catuta0/HAB-payload/BOM.csv

References | Qty | Description | Package | Manufacturer | MPN | Mouser PN | Mouser link | Unit price | Currency | Line total | Price source | Notes
U8,U9 | 2 | TPS62160DGK step-down 3-17V 1A | VSSOP-8 (MSOP-8) | Texas Instruments | TPS62160DGKR | 595-TPS62160DGKR | https://www.mouser.com/ProductDetail/595-TPS62160DGKR | 1.56 | EUR | 3.12 | pt.mouser.com 2026-10-28, qty 1 | 3.3 V and 5 V bucks
L1,L2 | 2 | 2.2uH 20% shielded power inductor | 4x4 mm (XFL4020) | Coilcraft | XFL4020-222MEC | 994-XFL4020-222MEC | https://www.mouser.com/ProductDetail/994-XFL4020-222MEC | 1.98 | EUR | 3.96 | pt.mouser.com 2026-10-28, qty 1 | Out of stock at Mouser on 2026-10-27; alternative Wurth 74438357022 (710-74438357022, 4.1x4.1 mm) needs its land pattern checked against the XFL4020 footprint
F1 | 1 | PTC resettable fuse 1.5A hold 3A trip 16V | 1812 | Bourns | MF-MSMF150/16X-2 | 652-MF-MSMF150/16X-2 | https://www.mouser.com/ProductDetail/652-MF-MSMF150%2F16X-2 | 0.525 | EUR | 0.53 | pt.mouser.com 2026-10-28, qty 1 | Battery input protection
D2 | 1 | TVS 13V standoff bidirectional 600W | SMB (DO-214AA) | Littelfuse | SMBJ13CA | 576-SMBJ13CA | https://www.mouser.com/ProductDetail/576-SMBJ13CA | 0.525 | EUR | 0.53 | pt.mouser.com 2026-10-28, qty 1 | Battery input protection
Q11 | 1 | P-MOSFET 30V 4.3A | SOT-23 | Diodes Incorporated | DMP3056L-7 | 621-DMP3056L-7 | https://www.mouser.com/ProductDetail/621-DMP3056L-7 | 0.542 | EUR | 0.54 | pt.mouser.com 2026-10-28, qty 1 | Reverse polarity switch
R5 | 1 | 316k 1% 0805 | 0805 | Yageo | RC0805FR-07316KL | 603-RC0805FR-07316KL | https://www.mouser.com/ProductDetail/603-RC0805FR-07316KL | 0.086 | EUR | 0.09 | pt.mouser.com 2026-10-28, qty 1 | 3.3 V feedback
R7 | 1 | 523k 1% 0805 | 0805 | Yageo | RC0805FR-07523KL | 603-RC0805FR-07523KL | https://www.mouser.com/ProductDetail/603-RC0805FR-07523KL | 0.086 | EUR | 0.09 | pt.mouser.com 2026-10-28, qty 1 | 5 V feedback
R6,R8 | 2 | 100k 1% 0805 | 0805 | Yageo | RC0805FR-07100KL | 603-RC0805FR-07100KL | https://www.mouser.com/ProductDetail/603-RC0805FR-07100KL | 0.086 | EUR | 0.17 | pt.mouser.com 2026-10-28, qty 1 | Feedback bottom
R1,R2,R3,R4,R9 | 5 | 33R 1% 0805 | 0805 | Yageo | RC0805FR-0733RL | 603-RC0805FR-0733RL | https://www.mouser.com/ProductDetail/603-RC0805FR-0733RL | 0.086 | EUR | 0.43 | pt.mouser.com 2026-10-28, qty 1 | SPI series termination (R9 on SD MISO at MOD1)
C17,C19 | 2 | 10uF 50V X7R | 1210 | TDK | C3225X7R1H106K250AC | 810-C3225X7R1H106250 | https://www.mouser.com/ProductDetail/810-C3225X7R1H106250 | 0.877 | EUR | 1.75 | pt.mouser.com 2026-10-28, qty 1 | Buck input
C18,C20,C21,C23,C25 | 5 | 22uF 16V X7R | 1206 | Murata | GRM31CZ71C226ME15L | 81-GRM31CZ71C226ME5L | https://www.mouser.com/ProductDetail/81-GRM31CZ71C226ME5L | 0.912 | EUR | 4.56 | pt.mouser.com 2026-10-28, qty 1 | 3.3 V and 5 V buck outputs, pi filters, SD bulk (16 V part used on 3.3 V too for DC-bias margin)
C15,C16,C22,C24 | 4 | 100uF 10V polymer tantalum 55mOhm | 7343-31 (D) | KEMET | T520D107M010ATE055 | 80-T520D107M10E55 | https://www.mouser.com/ProductDetail/80-T520D107M10E55 | 1.53 | EUR | 6.12 | pt.mouser.com 2026-10-28, qty 1 | Solid polymer, -55 to +105 C
C2,C4,C6,C8,C10,C14 | 6 | 10uF 16V X7R | 0805 | Samsung | CL21B106KOQNNNE | 187-CL21B106KOQNNNE | https://www.mouser.com/ProductDetail/187-CL21B106KOQNNNE | 0.421 | EUR | 2.53 | pt.mouser.com 2026-10-28, qty 1 | Module local decoupling
C1,C3,C5,C7,C9,C13 | 6 | 100nF 50V X7R | 0805 | Samsung | CL21B104KBCNNNC | 187-CL21B104KBCNNNC | https://www.mouser.com/ProductDetail/187-CL21B104KBCNNNC | 0.086 | EUR | 0.52 | pt.mouser.com 2026-10-28, qty 1 | Module local decoupling
FB1,FB2 | 2 | Ferrite 120R@100MHz 3.5A | 1206 | Murata | BLM31PG121SN1L | 81-BLM31PG121SN1L | https://www.mouser.com/ProductDetail/81-BLM31PG121SN1L | 0.43 | EUR | 0.86 | pt.mouser.com 2026-10-28, qty 1 | Buck pi filter
FB3,FB4,FB5 | 3 | Ferrite 220R@100MHz 1.4A | 0603 | Murata | BLM18PG221SN1D | 81-BLM18PG221SN1D | https://www.mouser.com/ProductDetail/81-BLM18PG221SN1D | 0.12 | EUR | 0.36 | pt.mouser.com 2026-10-28, qty 1 | GPS, RFM95 and MAX31855 supply
J1 | 1 | JST XH 2-pin vertical | 2.5 mm | JST | B2B-XH-A(LF)(SN) | 306-B2BXHALFSNP | https://www.mouser.com/ProductDetail/306-B2BXHALFSNP | 0.086 | EUR | 0.09 | pt.mouser.com 2026-10-28, qty 1 | Battery input
U1,U3,U4,U6 | 4 | Female header 1x20 2.54 mm | THT | Wurth Elektronik | 61302011821 | 710-61302011821 | https://www.mouser.com/ProductDetail/710-61302011821 | 0.8 | EUR | 3.2 | pt.mouser.com 2026-10-28, qty 1 | Cut to length (each cut loses one position): two strips of 19 for the ESP32, one strip for U4 (9) + U3 (7), one strip for the two 1x7 rows of U6
U2 | 1 | Female header 1x8 2.54 mm | THT | Wurth Elektronik | 61300811821 | 710-61300811821 | https://www.mouser.com/ProductDetail/710-61300811821 | 0.353 | EUR | 0.35 | pt.mouser.com 2026-10-28, qty 1 | INA260
U5,MOD1 | 2 | Female header 1x6 2.54 mm | THT | Wurth Elektronik | 61300611821 | 710-61300611821 | https://www.mouser.com/ProductDetail/710-61300611821 | 0.258 | EUR | 0.52 | pt.mouser.com 2026-10-28, qty 1 | MAX31855 and SD module
U7,U10 | 2 | Female header 1x4 2.54 mm | THT | Wurth Elektronik | 61300411821 | 710-61300411821 | https://www.mouser.com/ProductDetail/710-61300411821 | 0.361 | EUR | 0.72 | pt.mouser.com 2026-10-28, qty 1 | GPS I2C and GPS UART; solder only the one in use
TP1,TP2,TP3,TP4 | 0 | Test pad 1.5 mm | SMD pad |  |  |  | not applicable (part of the PCB) |  |  |  |  | Bare copper pads, nothing to buy
H1,H2,H3,H4 | 0 | M3 mounting hole | 3.2 mm |  |  |  | not applicable (part of the PCB) |  |  |  |  | Nothing to buy
U1 | 1 | ESP32-DevKitC V4 38-pin with ESP32-WROOM-32 (not WROVER: IO16/IO17 are used) | module | Espressif | ESP32-DevKitC-32E | 356-ESP32-DEVKITC32E | https://www.mouser.com/ProductDetail/356-ESP32-DEVKITC32E | 8.78 | EUR | 8.78 | pt.mouser.com 356-ESP32-DEVKITC32E | Bought separately; powered from its 3V3 pin
U2 | 1 | Adafruit INA260 breakout | module | Adafruit | 4226 |  | https://www.adafruit.com/product/4226 | 9.95 | USD | 9.95 | adafruit.com | Bought separately; VBUS/IN+/IN- wired off-board to the battery
U3 | 1 | Adafruit BME280 breakout | module | Adafruit | 2652 |  | https://www.adafruit.com/product/2652 | 14.95 | USD | 14.95 | adafruit.com | Bought separately
U4 | 1 | Adafruit LSM6DSOX breakout | module | Adafruit | 4438 |  | https://www.adafruit.com/product/4438 | 11.95 | USD | 11.95 | adafruit.com | Bought separately
U5 | 1 | Adafruit MAX31855 thermocouple breakout | module | Adafruit | 269 |  | https://www.adafruit.com/product/269 | 14.95 | USD | 14.95 | adafruit.com | Bought separately; needs a type K thermocouple
U6 | 1 | RFM95W LoRa module 868 MHz | module | HopeRF / attexx | RFM95W-868S2 |  | https://soselectronic.com/en/products/rfm95w-868-s2 | 6.98 | EUR | 6.98 | soselectronic.com 2026-10-28, excl. VAT | Mounted on the attexx breakout PCB (row below)
U6 PCB | 1 | attexx rfm9x_breakout_board rev 1b (bare PCB) | PCB | AISLER |  |  | https://aisler.net/p/BNYBJOFL |  |  |  | price on aisler.net (sold in sets of 3) | Design: github.com/attexx/rfm9x_breakout_board; also needs C1 10uF 0805 (use a spare CL21B106KOQNNNE)
U6 J1 | 1 | SMA female edge-launch jack 50 Ohm for 1.6 mm (0.062 in) PCB | Edge mount | TE Connectivity / Linx | CONSMA003.062-G | 712-CONSMA003.062-G | https://www.mouser.com/ProductDetail/712-CONSMA003.062-G | 3.84 | EUR | 3.84 | pt.mouser.com 2026-10-28 | Antenna connector on the RFM95 breakout; matches its footprint (centre 1.52 mm, ground legs at 2.54 mm); takes the SMA male of the antenna (not RP-SMA)
U7 or U10 | 1 | GPS NEO-8M breakout (I2C on U7 or UART on U10) | module |  |  |  | https://www.botnroll.com/en/gps-gnss/5479-uart-gps-neo-8m-w-ceramic-antenna.html | 18.9 | EUR | 18.9 | botnroll.com 2026-10-28 (UART version; any NEO-8M breakout with the same pin order works) | Fit only one; check the pin order matches VCC RX TX GND (UART) or VCC GND SCL SDA (I2C) before soldering the header
MOD1 | 1 | AZ-Delivery SPI micro SD card module | module | AZ-Delivery |  |  | https://www.az-delivery.de/en/products/copy-of-spi-reader-micro-speicherkartenmodul-fur-arduino | 4.49 | EUR | 4.49 | az-delivery.de | Bought separately; powered from 5 V; use an industrial-temperature card
ANT1 | 1 | 868 MHz half-wave dipole antenna 3.2 dBi peak 93% efficiency, -40 to +85 C | SMA male, 389 mm | Taoglas | TI.18.3113 | 960-TI.18.3113 | https://www.mouser.com/ProductDetail/960-TI.18.3113 | 13.27 | EUR | 13.27 | pt.mouser.com 2026-10-28 | Plugs into the SMA on the RFM95 breakout; no ground plane needed; hinged, tape it straight for flight
ANT2 | 1 | GNSS active patch antenna 25x25 mm, 2-stage LNA 28 dB with SAW filter, GPS/GLONASS/Galileo, -40 to +85 C | 25x25x7.4 mm, 60 mm cable, U.FL | Taoglas | AGGP.25F.07.0060A | 960-AGGP25F.07.0060A | https://www.mouser.com/ProductDetail/960-AGGP25F.07.0060A | 15.98 | EUR | 15.98 | pt.mouser.com 2026-10-28 | For the GPS module U.FL; needs antenna bias from the module (measure about 3 V DC on the U.FL centre pin), otherwise keep the passive patch
TOTAL |  |  |  |  |  |  |  |  | EUR | 103.28 | All parts priced in EUR (Mouser, ESP32, SD, RFM95W, GPS, SMA, antennas)
TOTAL |  |  |  |  |  |  |  |  | USD | 51.8 | Adafruit modules (adafruit.com) | attexx PCB, main PCB fabrication and shipping not included
