catuta0/HAB-payload/hardware/pcbgalapagos.kicad_pcb

## KiCad design hardware/pcbgalapagos.kicad_pcb (2026-10-28)

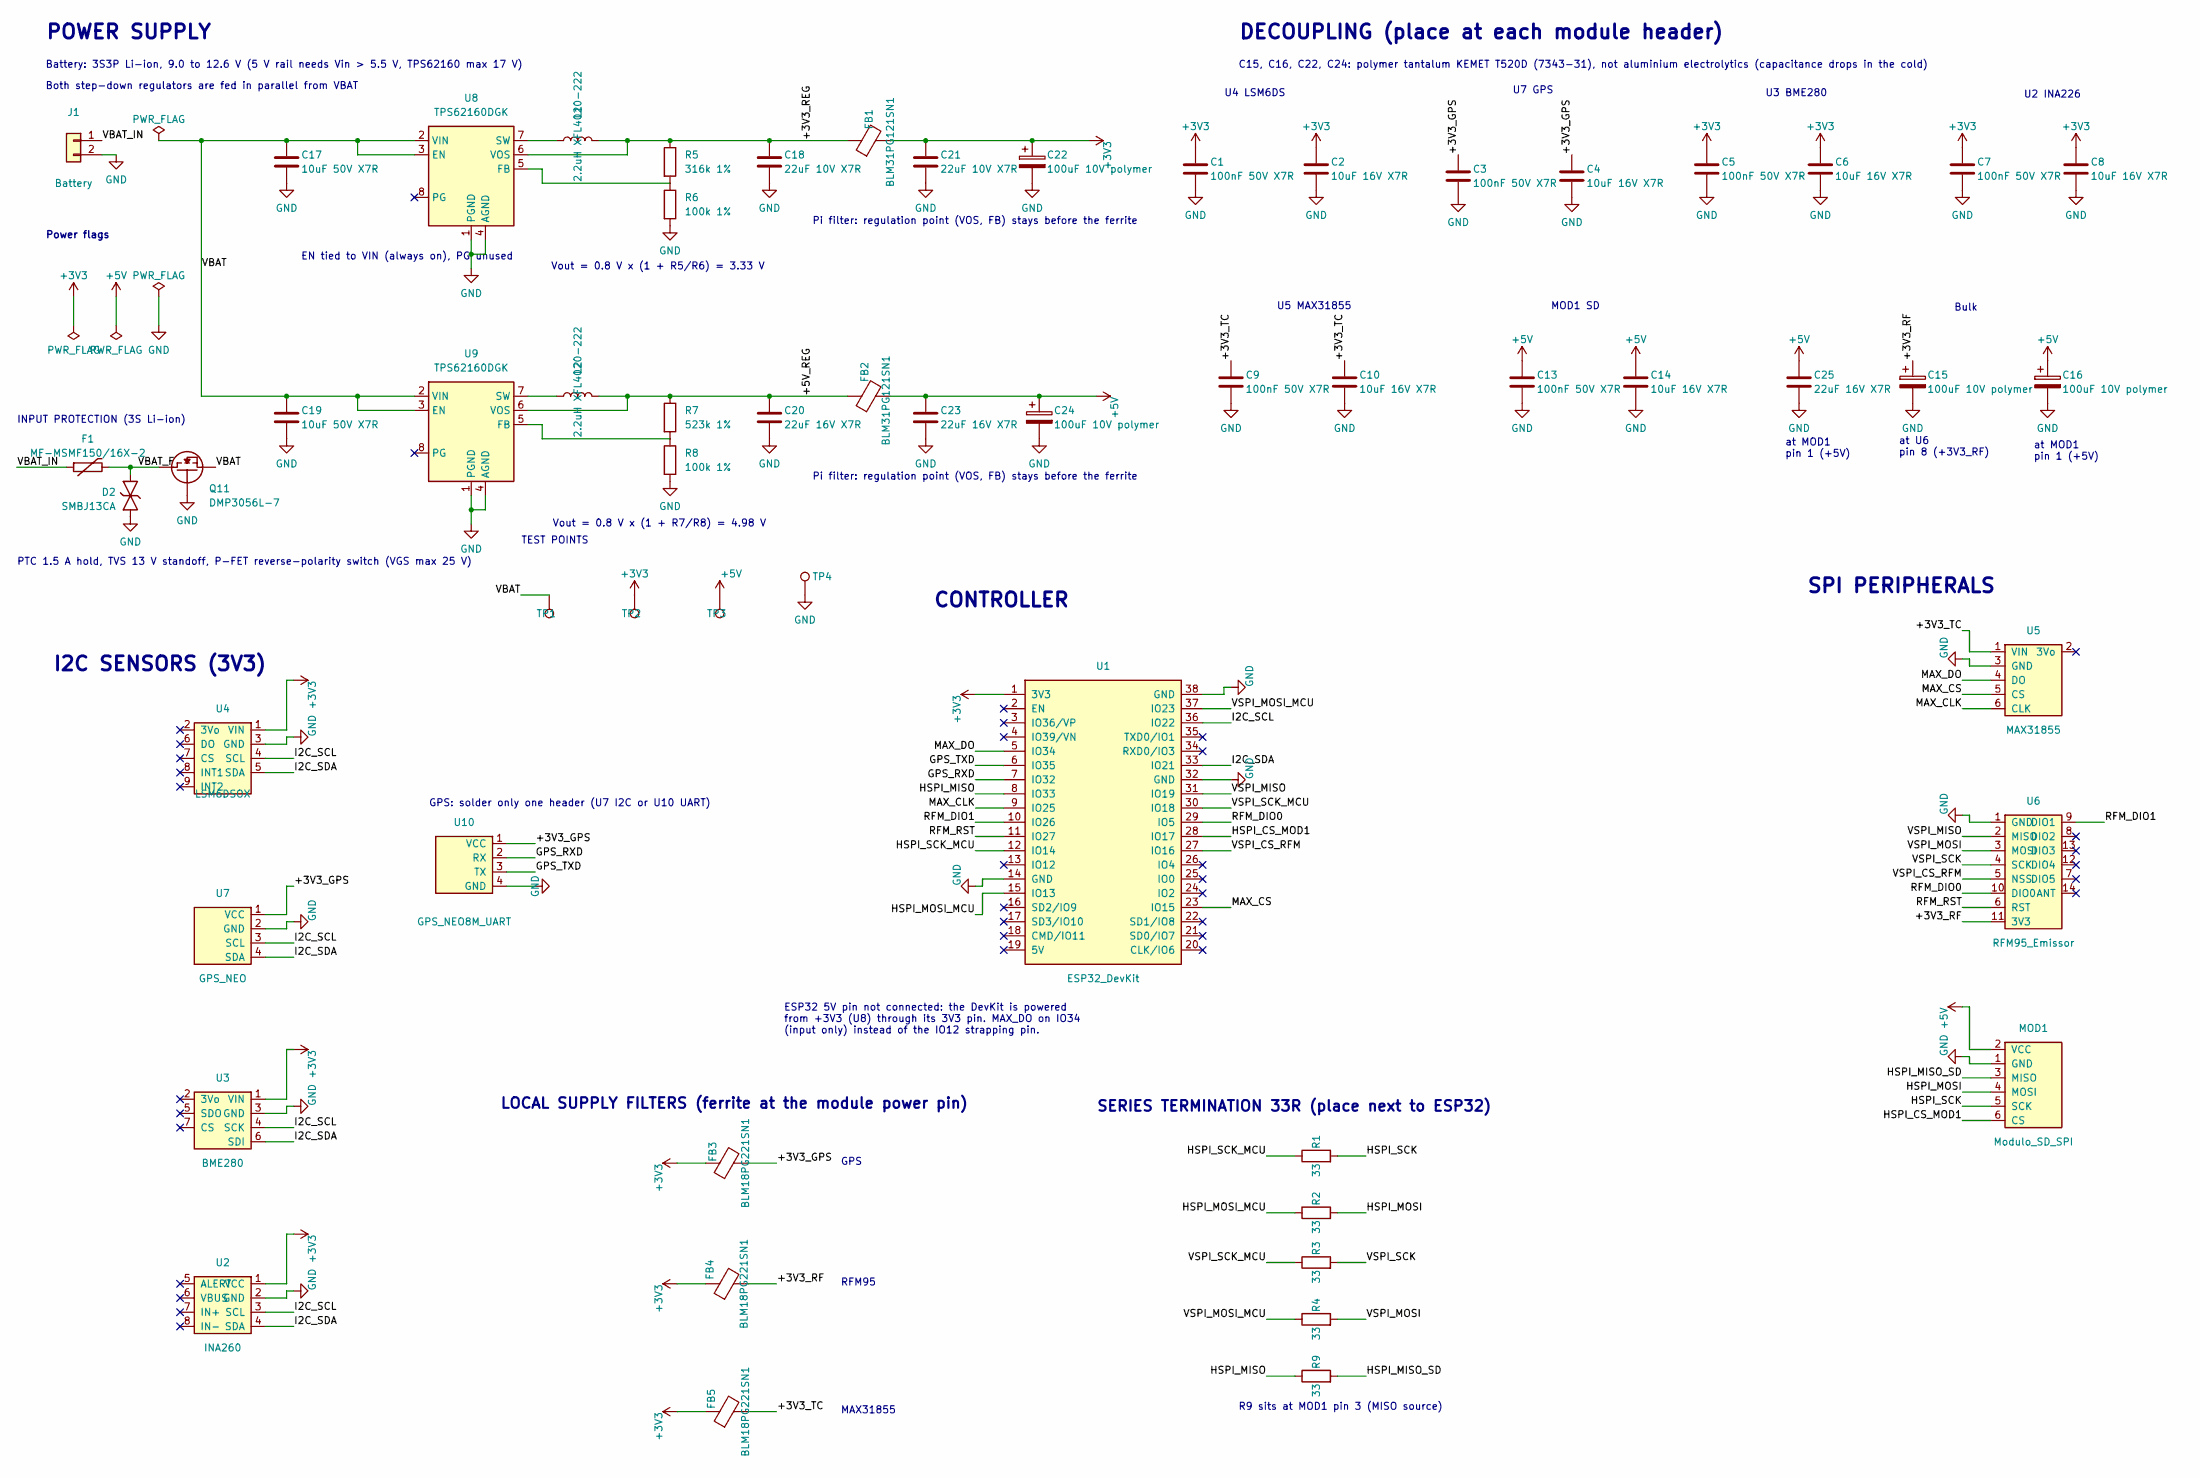
[picture p1: schematic pcbgalapagos.kicad_sch, Galapagos]

Parts:
C1, C3, C5, C7, C9, C13: 100nF 50V X7R; C_0805_2012Metric
C2, C4, C6, C8, C10, C14: 10uF 16V X7R; C_0805_2012Metric
C15, C16, C22, C24: 100uF 10V polymer; CP_EIA-7343-31_Kemet-D
C17, C19: 10uF 50V X7R; C_1210_3225Metric
C18, C21: 22uF 10V X7R; C_1206_3216Metric
C20, C23, C25: 22uF 16V X7R; C_1206_3216Metric
D2: SMBJ13CA; D_SMB
F1: MF-MSMF150/16X-2; Fuse_1812_4532Metric
FB1, FB2: BLM31PG121SN1; L_1206_3216Metric
FB3, FB4, FB5: BLM18PG221SN1; L_0603_1608Metric
J1: Battery; JST_XH_B2B-XH-A_1x02_P2.50mm_Vertical
L1, L2: 2.2uH XFL4020-222; L_Coilcraft_XxL4020
MOD1: Modulo_SD_SPI; PinHeader_1x06_P2.54mm_Vertical
Q11: DMP3056L-7; SOT-23
R1, R2, R3, R4, R9: 33; R_0805_2012Metric
R5: 316k 1%; R_0805_2012Metric
R6, R8: 100k 1%; R_0805_2012Metric
R7: 523k 1%; R_0805_2012Metric
TP1, TP2, TP3, TP4: TestPoint; TestPoint_Pad_D1.5mm
U1: ESP32_DevKit; ESP32_DevKitC_V4_38
U2: INA260; Adafruit_INA260_Header
U3: BME280; Adafruit_BME280_Header
U4: LSM6DSOX; Adafruit_LSM6DSOX_Header
U5: MAX31855; Adafruit_MAX31855_Header
U6: RFM95_Emissor; RFM9x_Breakout_attexx
U7: GPS_NEO; GPS_I2C_Header_1x04
U8, U9: TPS62160DGK; MSOP-8_3x3mm_P0.65mm
U10: GPS_NEO8M_UART; GPS_NEO8M_UART_Header_1x04

Connections:
+3V3: C1.1, C2.1, C5.1, C6.1, C7.1, C8.1, C21.1, C22.1, FB1.2, FB3.1, FB4.1, FB5.1, TP2.1, U1.1 (3V3), U2.1 (VCC), U3.1 (VIN), U4.1 (VIN)
+3V3_GPS: C3.1, C4.1, FB3.2, U7.1 (VCC), U10.1 (VCC)
+3V3_REG: C18.1, FB1.1, L1.2, R5.1, U8.6 (VOS)
+3V3_RF: C15.1, FB4.2, U6.11 (3V3)
+3V3_TC: C9.1, C10.1, FB5.2, U5.1 (VIN)
+5V: C13.1, C14.1, C16.1, C23.1, C24.1, C25.1, FB2.2, MOD1.2 (VCC), TP3.1
+5V_REG: C20.1, FB2.1, L2.2, R7.1, U9.6 (VOS)
GND: C1.2, C2.2, C3.2, C4.2, C5.2, C6.2, C7.2, C8.2, C9.2, C10.2, C13.2, C14.2, C15.2, C16.2, C17.2, C18.2, C19.2, C20.2, C21.2, C22.2, C23.2, C24.2, C25.2, D2.2 (A2), J1.2, MOD1.1 (GND), Q11.1 (G), R6.2, R8.2, TP4.1, U1.14 (GND), U1.32 (GND), U1.38 (GND), U2.2 (GND), U3.3 (GND), U4.3 (GND), U5.3 (GND), U6.1 (GND), U7.2 (GND), U8.1 (PGND), U8.4 (AGND), U9.1 (PGND), U9.4 (AGND), U10.4 (GND)
GPS_RXD: U1.7 (IO32), U10.2 (RX)
GPS_TXD: U1.6 (IO35), U10.3 (TX)
HSPI_CS_MOD1: MOD1.6 (CS), U1.28 (IO17)
HSPI_MISO: R9.1, U1.8 (IO33)
HSPI_MISO_SD: MOD1.3 (MISO), R9.2
HSPI_MOSI: MOD1.4 (MOSI), R2.2
HSPI_MOSI_MCU: R2.1, U1.15 (IO13)
HSPI_SCK: MOD1.5 (SCK), R1.2
HSPI_SCK_MCU: R1.1, U1.12 (IO14)
I2C_SCL: U1.36 (IO22), U2.3 (SCL), U3.4 (SCK), U4.4 (SCL), U7.3 (SCL)
I2C_SDA: U1.33 (IO21), U2.4 (SDA), U3.6 (SDI), U4.5 (SDA), U7.4 (SDA)
MAX_CLK: U1.9 (IO25), U5.6 (CLK)
MAX_CS: U1.23 (IO15), U5.5 (CS)
MAX_DO: U1.5 (IO34), U5.4 (DO)
unnamed: R5.2, R6.1, U8.5 (FB)
unnamed: L1.1, U8.7 (SW)
unnamed: R7.2, R8.1, U9.5 (FB)
unnamed: L2.1, U9.7 (SW)
RFM_DIO0: U1.29 (IO5), U6.10 (DIO0)
RFM_DIO1: U1.10 (IO26), U6.9 (DIO1)
RFM_RST: U1.11 (IO27), U6.6 (RST)
VBAT: C17.1, C19.1, Q11.2 (S), TP1.1, U8.2 (VIN), U8.3 (EN), U9.2 (VIN), U9.3 (EN)
VBAT_F: D2.1 (A1), F1.2, Q11.3 (D)
VBAT_IN: F1.1, J1.1
VSPI_CS_RFM: U1.27 (IO16), U6.5 (NSS)
VSPI_MISO: U1.31 (IO19), U6.2 (MISO)
VSPI_MOSI: R4.2, U6.3 (MOSI)
VSPI_MOSI_MCU: R4.1, U1.37 (IO23)
VSPI_SCK: R3.2, U6.4 (SCK)
VSPI_SCK_MCU: R3.1, U1.30 (IO18)

Notes on the sheet:
Vout = 0.8 V x (1 + R5/R6) = 3.33 V
CONTROLLER
RFM95
Bulk
PTC 1.5 A hold, TVS 13 V standoff, P-FET reverse-polarity switch (VGS max 25 V)
Vout = 0.8 V x (1 + R7/R8) = 4.98 V
MAX31855
Power flags
GPS
U2 INA226
at MOD1 pin 1 (+5V)
INPUT PROTECTION (3S Li-ion)
MOD1 SD
SPI PERIPHERALS
SERIES TERMINATION 33R (place next to ESP32)
U7 GPS
U3 BME280
C15, C16, C22, C24: polymer tantalum KEMET T520D (7343-31), not aluminium electrolytics (capacitance drops in the cold)
Battery: 3S3P Li-ion, 9.0 to 12.6 V (5 V rail needs Vin > 5.5 V, TPS62160 max 17 V)
at U6 pin 8 (+3V3_RF)
DECOUPLING (place at each module header)
Both step-down regulators are fed in parallel from VBAT
I2C SENSORS (3V3)
Pi filter: regulation point (VOS, FB) stays before the ferrite
POWER SUPPLY
U5 MAX31855
LOCAL SUPPLY FILTERS (ferrite at the module power pin)
EN tied to VIN (always on), PG unused
U4 LSM6DS
ESP32 5V pin not connected: the DevKit is powered from +3V3 (U8) through its 3V3 pin. MAX_DO on IO34 (input only) instead of the IO12 strapping pin.
GPS: solder only one header (U7 I2C or U10 UART)
R9 sits at MOD1 pin 3 (MISO source)
TEST POINTS

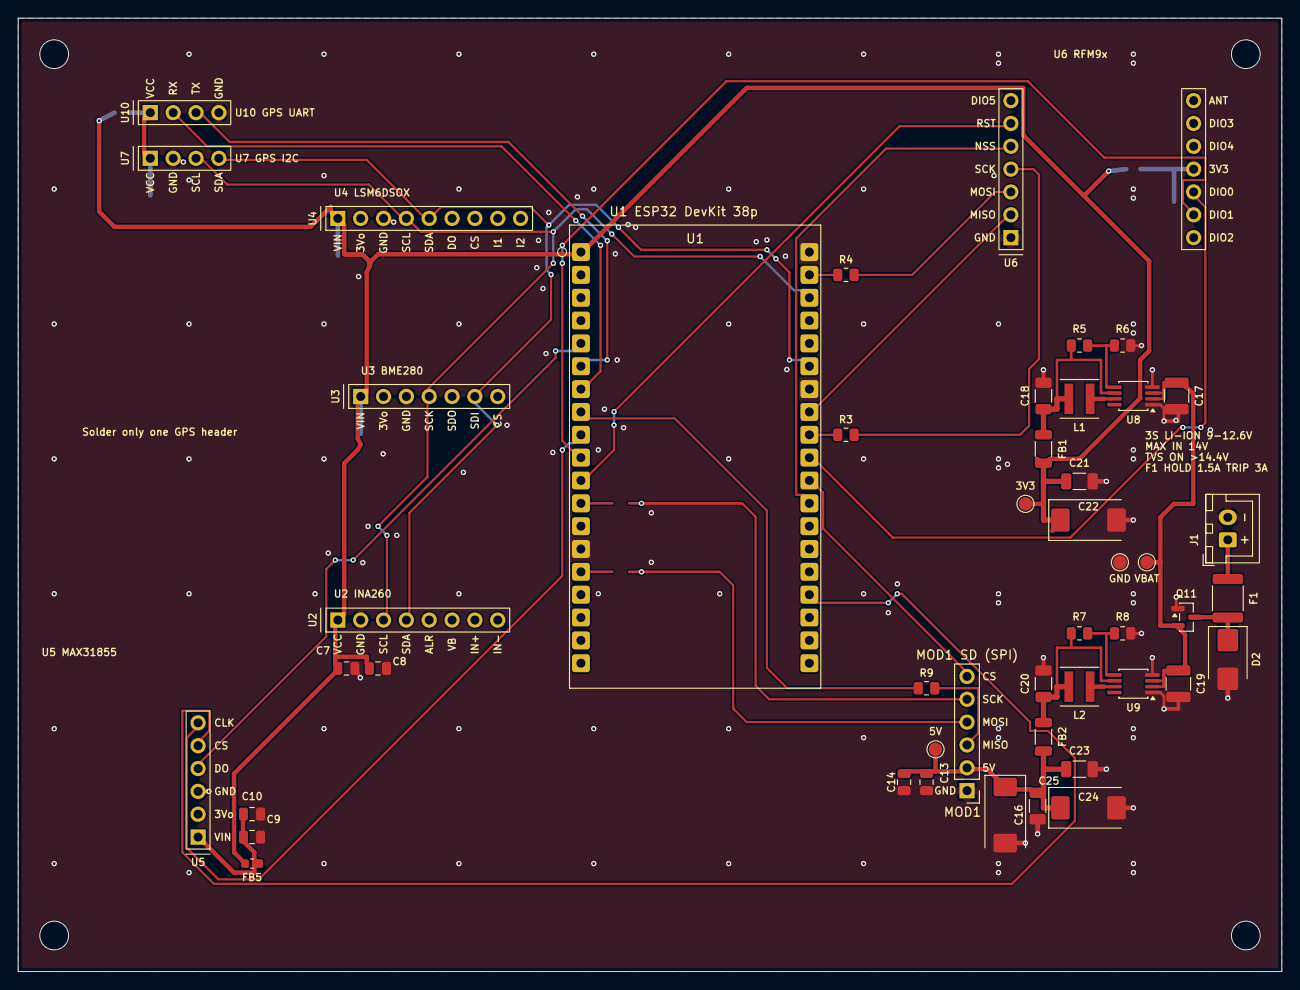
[picture p2: board pcbgalapagos.kicad_pcb from above]

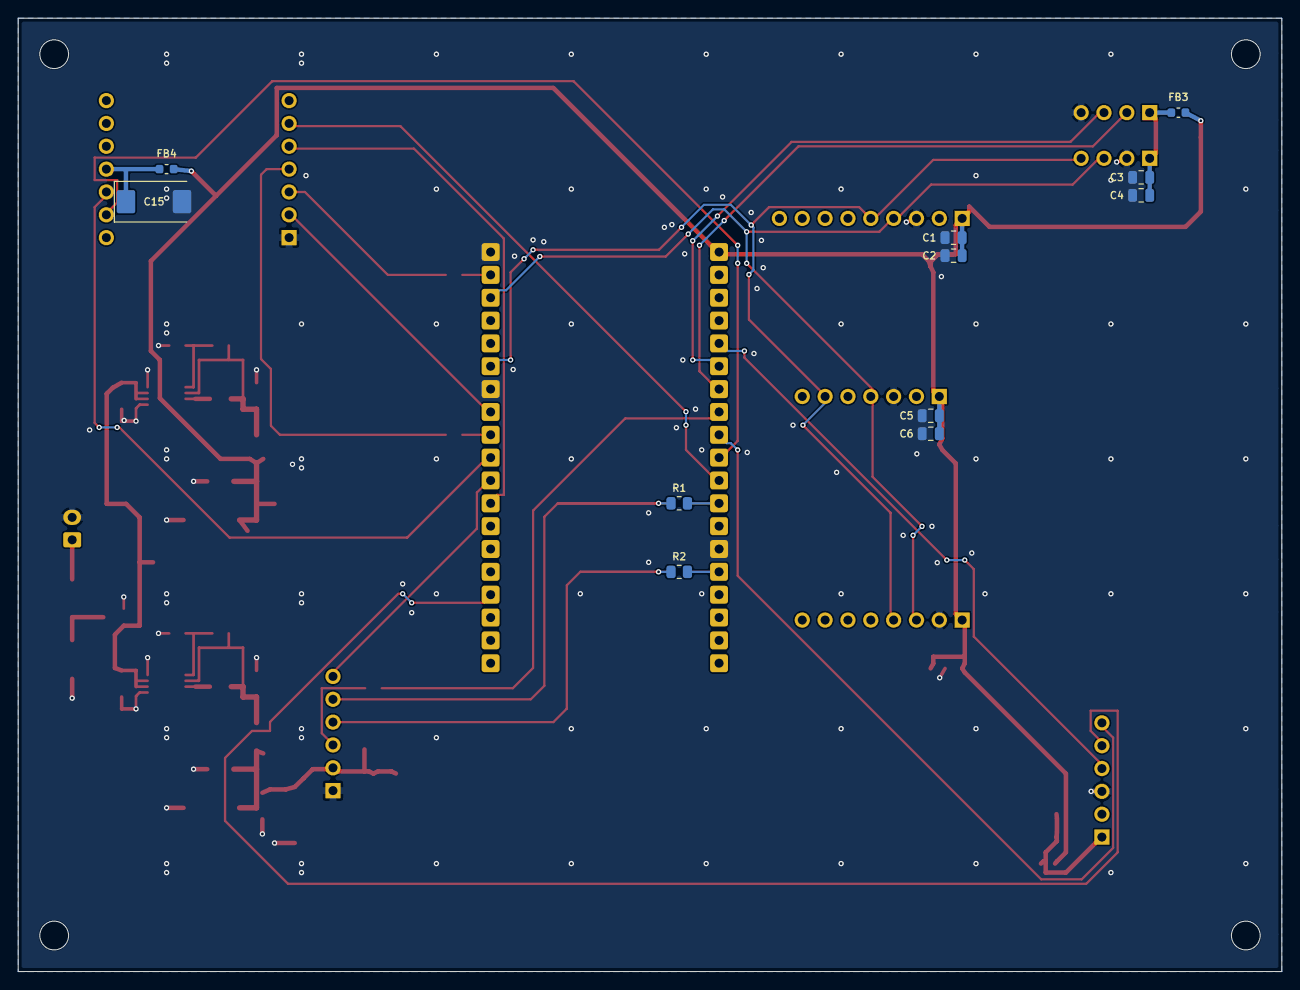
[picture p3: board pcbgalapagos.kicad_pcb from below]

Board: 2 copper layers, 140.5 x 106.0 mm, 62 parts (11 on the bottom side), 38 nets.

Other parts of the board:
H1, H2, H3, H4: MountingHole_3.2mm_M3
