catuta0/HAB-payload/(commit log)

2026-10-27 Add KiCad schematic, PCB and BOM
    [BOM.csv, pcbgalapagos.kicad_pcb, pcbgalapagos.kicad_sch]
2026-10-27 README: power from rechargeable Li-ion pack
2026-10-28 Final PCB, schematic and project libraries
    Replace hardware with the final KiCad 10 project: module headers matched
    to the real breakouts, GPS UART header, input protection, MISO series
    termination, test points, solid SMD pour connections. Add the project
    footprint library and fp-lib-table. Drop the outdated BOM and renders.
    [BOM.csv, pcbgalapagos.kicad_pcb, pcbgalapagos.kicad_sch]
2026-10-28 PCB: refill GND zones
    [pcbgalapagos.kicad_pcb]
2026-10-28 Add BOM and firmware change notes
    [BOM.csv]
2026-10-28 BOM: add prices, LoRa antenna, in-stock 22uF part
    [BOM.csv]
2026-10-28 BOM: SMA edge connector, RFM breakout PCB, links for every part
    [BOM.csv]
2026-10-28 BOM: add active GNSS antenna
    [BOM.csv]
2026-10-28 PCB: move parts under the modules to the bottom side
    Decoupling caps C1-C6, C15, ferrites FB3/FB4 and SPI terminations R1/R2
    now sit on the bottom layer next to the module header pins, so nothing
    is sandwiched between the board and the plug-in modules.
    [pcbgalapagos.kicad_pcb]
2026-10-28 Update firmware changes for GPS and SD card handling
    Clarified GPS setup instructions and emphasized the need for a backup cell. Updated details on SD card logging and pin assignments.
2026-10-28 docs: fix typos in power supply notes
2026-10-28 Update power supply instructions in firmware_changes.md
    Clarified power supply instructions for the ESP32.
